JasonClock/CNC_Buck/docs/# buck 注意事项.md

# buck 注意事项
需要选择低DCR的电感，以减小影响满载效率的导通损耗（P=I^2^ * R)
可以高于目标值的饱和电流
