JasonClock/CNC_Buck/docs/项目出现的问题.md

# 项目设计时出现的问题
## 烧录问题
我的buck的板子的stm32f334r8在用daplink烧录时出现了下面的问题E:\clion\embedded_Env\openocd-v0.12.0-i686-w64-mingw32\bin\openocd.exe -s E:\clion\embedded_Env\openocd-v0.12.0-i686-w64-mingw32\share\openocd\scripts -f D:\stm32_workspace\all_kind_config_board\cmsisdap_stm32f3x.cfg -c "tcl_port disabled" -c "gdb_port disabled" -c "tcl_port disabled" -c "program \"D:/rm/DX_CNC buck/program/DX_CMC_Buck/build/Debug/DX_CMC_Buck.elf\"" -c reset -c shutdown
[0m[0mOpen On-Chip Debugger 0.12.0 (2023-01-14-23:37)
Licensed under GNU GPL v2
For bug reports, read
        http://openocd.org/doc/doxygen/bugs.html
Info : auto-selecting first available session transport "swd". To override use '
transport select <transport>'.
Info : Using CMSIS-DAPv2 interface with VID:PID=0xfaed:0x4870, serial=4866556863
11
Info : CMSIS-DAP: SWD supported
Info : CMSIS-DAP: JTAG supported
Info : CMSIS-DAP: Atomic commands supported
Info : CMSIS-DAP: UART via USB COM port supported
Info : CMSIS-DAP: FW Version = Horco v0.2
Info : CMSIS-DAP: Interface Initialised (SWD)
Info : SWCLK/TCK = 1 SWDIO/TMS = 1 TDI = 0 TDO = 1 nTRST = 0 nRESET = 1
Info : CMSIS-DAP: Interface ready
Info : clock speed 1000 kHz
Info : SWD DPIDR 0x2ba01477
Info : [stm32f3x.cpu] Cortex-M4 r0p1 processor detected
Info : [stm32f3x.cpu] target has 6 breakpoints, 4 watchpoints
Info : gdb port disabled
[stm32f3x.cpu] halted due to debug-request, current mode: Thread
xPSR: 0x01000000 pc: 0xfffffffe msp: 0xfffffffc
** Programming Started **
Info : device id = 0x10016438
Info : flash size = 64 KiB
Warn : Adding extra erase range, 0x08006ca4 .. 0x08006fff
Info : SWD DPIDR 0x2ba01477
Error: Failed to write memory at 0x20003004
Error: error writing to flash at address 0x08000000 at offset 0x00000000
embedded:startup.tcl:1516: Error: ** Programming Failed **
in procedure 'program'
in procedure 'program_error' called at file "embedded:startup.tcl", line 1581
at file "embedded:startup.tcl", line 1516

GPT解答：
你这个问题**大概率是 OpenOCD 的 STM32F3 默认 SRAM 工作区太大**，不是你的 flash 坏了。

关键日志是：

```text
Error: Failed to write memory at 0x20003004
Error: error writing to flash at address 0x08000000
```

`0x20003004` 很关键。

STM32F334R8 的普通 SRAM 是 **12 KB**，范围大约是：

```text
0x20000000 ~ 0x20002FFF
```

而 OpenOCD 正在尝试写：

```text
0x20003004
```

这已经超过了 12 KB SRAM 边界。STM32F334 还有 4 KB CCM RAM，但它不是接在 `0x20003000` 后面的连续 SRAM，OpenOCD 默认 flash loader 不能把它当作普通 work area 用。ST 官方资料也写了 F334x4/x6/x8 是最高 64 KB Flash、12 KB SRAM，另有 4 KB CCM SRAM。([STMicroelectronics](https://www.st.com/resource/en/datasheet/stm32f334k4.pdf?utm_source=chatgpt.com))

所以你的现象可以理解为：

```text
OpenOCD 连接芯片成功
↓
识别到 STM32F3 Cortex-M4 成功
↓
准备烧录 flash
↓
需要先把 flash programming algorithm 放到 SRAM 里运行
↓
但 OpenOCD 用了过大的 SRAM work area
↓
写到了 0x20003004，越界
↓
烧录失败
```

------

## 你应该这样改

找到你的这个配置文件：

```text
D:\stm32_workspace\all_kind_config_board\cmsisdap_stm32f3x.cfg
```

里面大概率有类似：

```tcl
source [find interface/cmsis-dap.cfg]
source [find target/stm32f3x.cfg]
```

你要在 `source [find target/stm32f3x.cfg]` **之前**加一行：

```tcl
set WORKAREASIZE 0x2000
```

推荐改成这样：

```tcl
source [find interface/cmsis-dap.cfg]

transport select swd
adapter speed 500

set WORKAREASIZE 0x2000

source [find target/stm32f3x.cfg]

reset_config none
```

`0x2000 = 8 KB`，比 12 KB 保守，基本不会越界。

也可以用：

```tcl
set WORKAREASIZE 0x2800
```

但我建议你先用 `0x2000`，稳定优先。

------

## 为什么不是直接设成 0x3000？

理论上 12 KB 就是：

```text
0x3000
```

但 flash loader 自己可能还会用到一点栈、临时变量或者对齐空间。为了避免刚好顶到边界，先用：

```text
0x2000
```

更稳。

------

## 你的日志里其他信息怎么看？

这些是正常的，说明连接没问题：

```text
Info : CMSIS-DAP: Interface Initialised (SWD)
Info : SWD DPIDR 0x2ba01477
Info : [stm32f3x.cpu] Cortex-M4 r0p1 processor detected
Info : flash size = 64 KiB
```

这句也符合 F334R8：

```text
Info : flash size = 64 KiB
```

异常的是这两句：

```text
pc: 0xfffffffe
msp: 0xfffffffc
```

这说明当前芯片里原本的程序向量表可能是无效的，或者 flash 内容还没烧进去/被擦坏了。这个本身不一定是根因，真正导致烧录失败的是后面的 SRAM 越界。

------

## 你也可以直接换命令测试

如果不用你自己的 `cmsisdap_stm32f3x.cfg`，可以临时这样试：

```bat
E:\clion\embedded_Env\openocd-v0.12.0-i686-w64-mingw32\bin\openocd.exe ^
-s E:\clion\embedded_Env\openocd-v0.12.0-i686-w64-mingw32\share\openocd\scripts ^
-f interface/cmsis-dap.cfg ^
-c "transport select swd" ^
-c "adapter speed 500" ^
-c "set WORKAREASIZE 0x2000" ^
-f target/stm32f3x.cfg ^
-c "program \"D:/rm/DX_CNC buck/program/DX_CMC_Buck/build/Debug/DX_CMC_Buck.elf\" verify reset exit"
```

注意：
`set WORKAREASIZE 0x2000` 必须在：

```text
-f target/stm32f3x.cfg
```

之前。

------

## 如果改完还是失败，再检查这几项

1. **SWD 速度先降到 100~500 kHz**

你的日志现在是：

```text
clock speed 1000 kHz
```

Buck 板子上电源噪声比较大，SWD 线又容易被功率部分干扰。可以先改：

```tcl
adapter speed 100
```

或者：

```tcl
adapter speed 500
```

1. **烧录时先不要给 Buck 主功率 48 V 上电**

只给 STM32 的 3.3 V，最好先断开 MOS 驱动、电感功率部分。
你这个是数控 Buck 板，功率地、电流采样、HRTIM PWM、驱动芯片都可能在上电瞬间制造干扰。

1. **BOOT0 下拉确认**

BOOT0 建议 10 kΩ 下拉到 GND。
如果 BOOT0 悬空，启动模式可能异常。

1. **NRST 接线检查**

DAPLink 的 `nRESET` 最好接到 STM32 的 NRST。
如果你的程序一启动就把 SWD 引脚配置错、进低功耗、开看门狗，后续可能需要 connect under reset。

1. **确认没有把 PA13/PA14 当普通 IO 用**

STM32F334 的 SWD 一般是：

```text
PA13 = SWDIO
PA14 = SWCLK
NRST = Reset
GND = GND
3V3 = VTref
```

------

## 结论

你这个日志最像：

```text
OpenOCD stm32f3x.cfg 默认 WORKAREASIZE = 0x4000
但 STM32F334R8 普通 SRAM 只有 0x3000
所以烧录算法写 SRAM 越界，导致 flash programming failed
```

优先修复：

```tcl
set WORKAREASIZE 0x2000
```

并且一定放在：

```tcl
source [find target/stm32f3x.cfg]
```

之前。
