JasonClock/CNC_Buck/(list of files, drawings)

Other design files:
docs/开关电路.ms14
docs/缓启动.ms14
