JasonClock/CNC_Buck/circuit/数控电源/数控buck.kicad_pcb

## KiCad design circuit/数控电源/数控buck.kicad_pcb (2026-05-04)

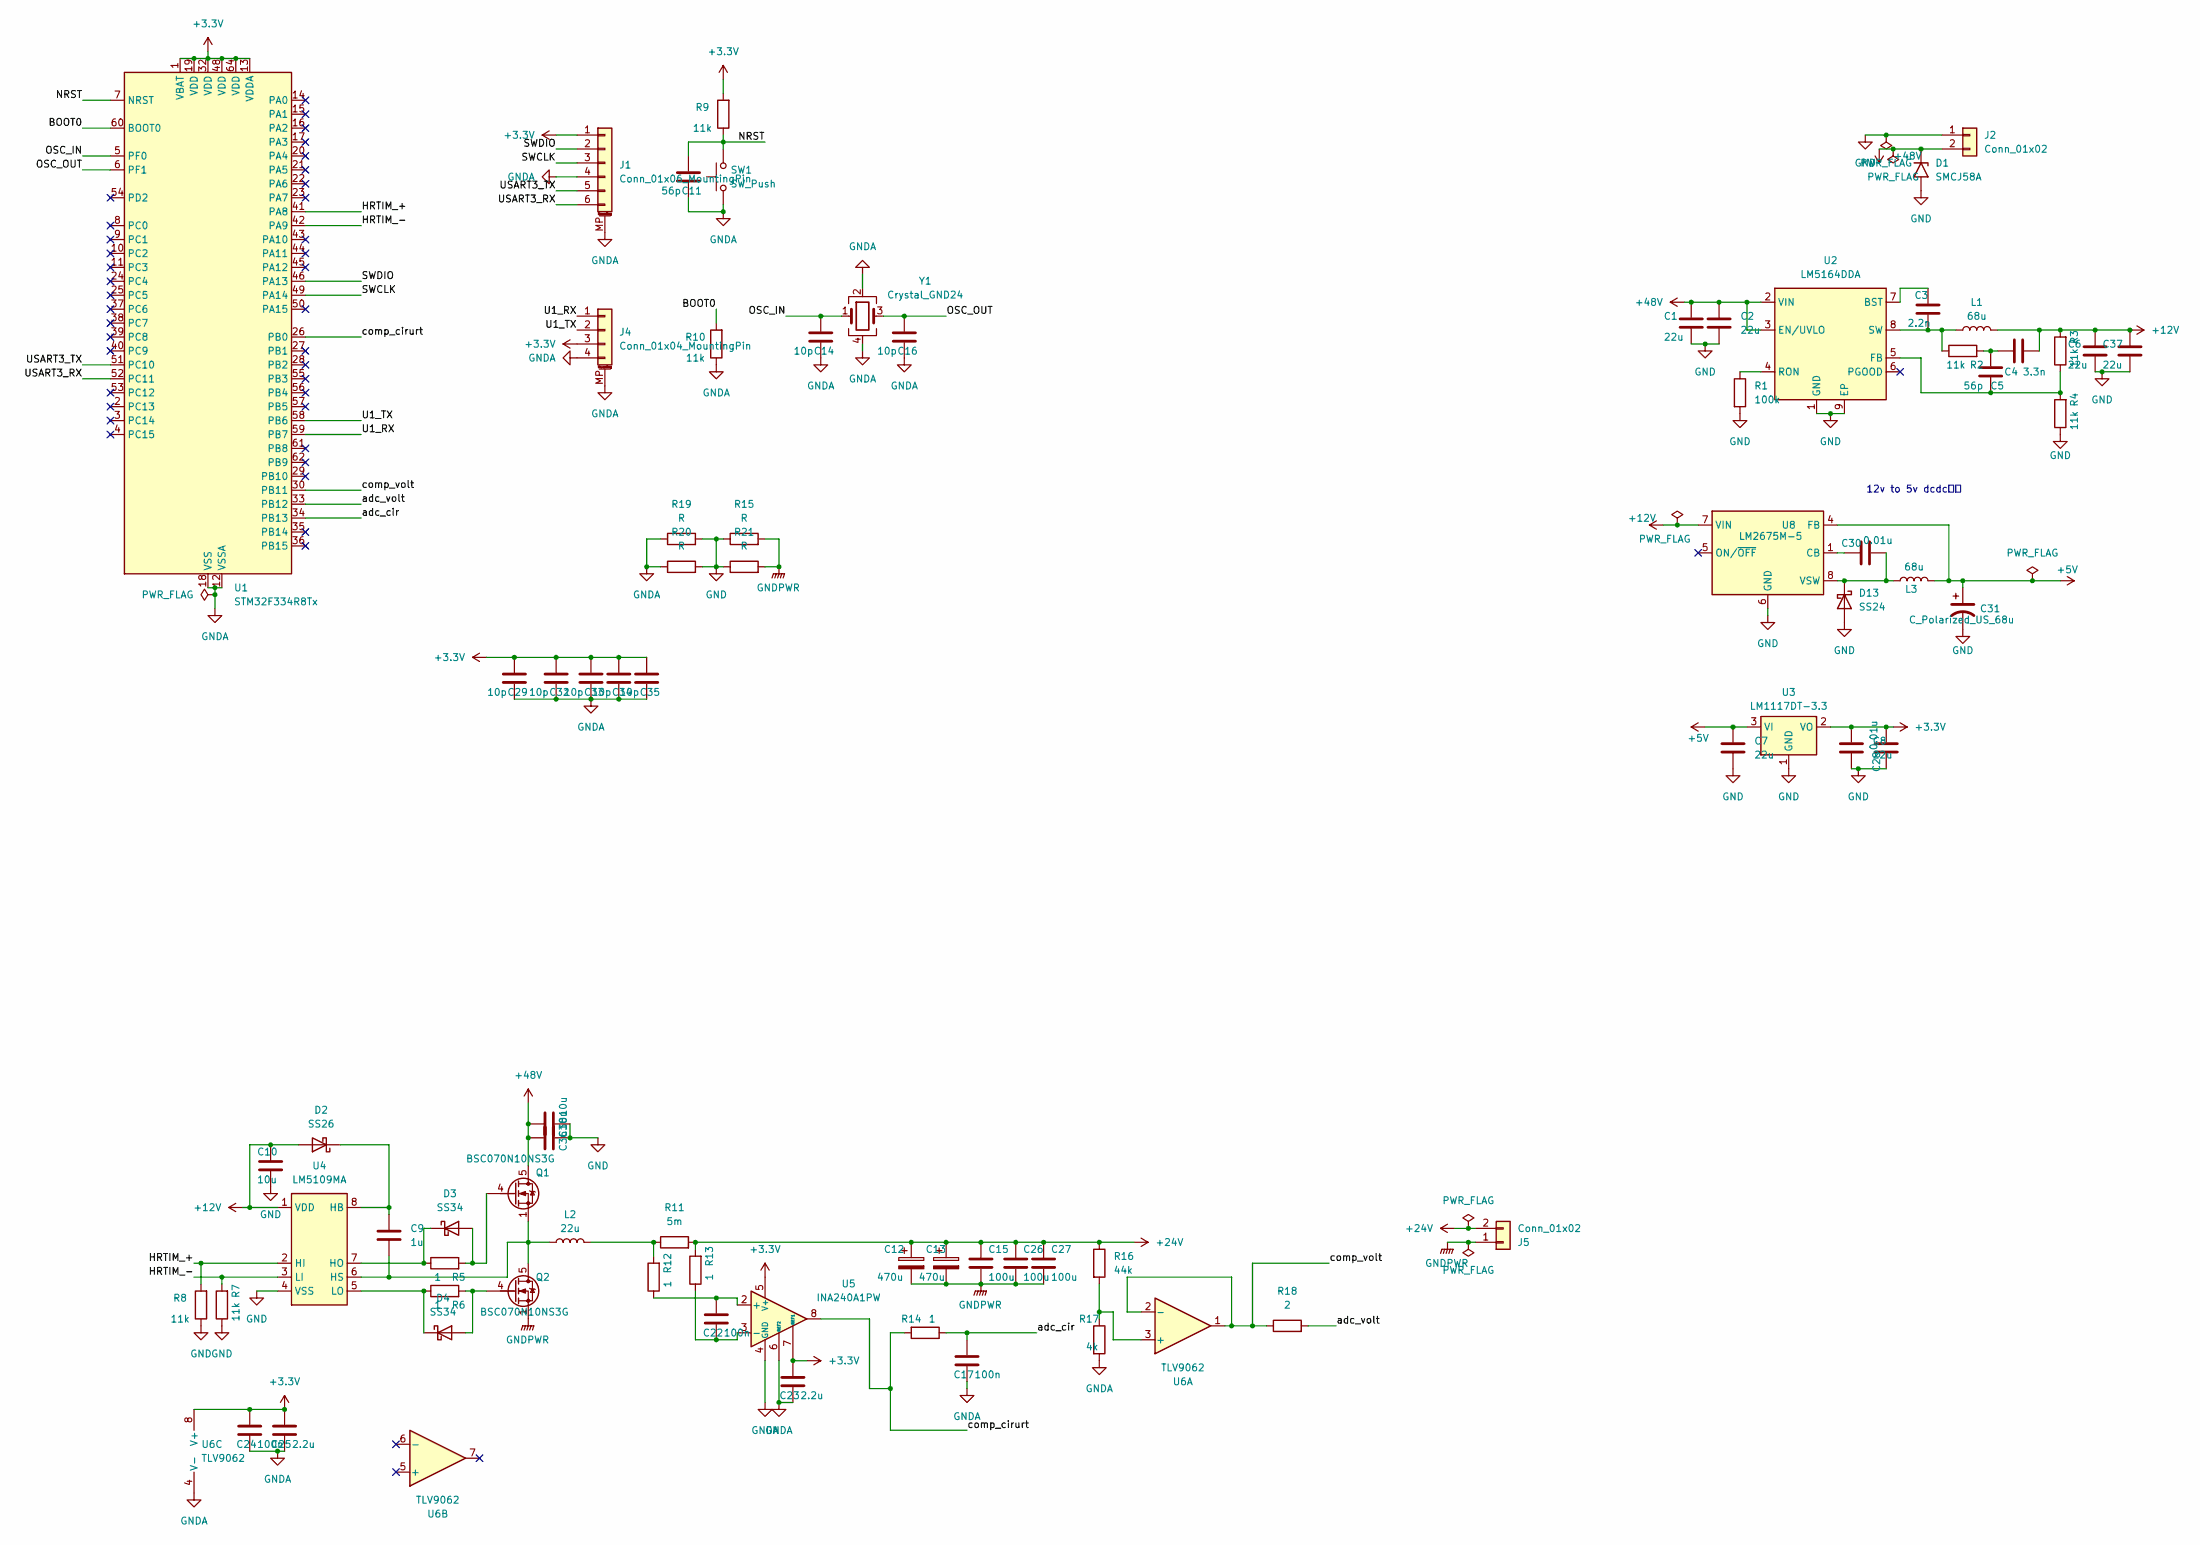
[picture p1: schematic 数控buck.kicad_sch]

Parts:
C1, C2, C6, C7, C8, C37: 22u; C_0805_2012Metric_Pad1.18x1.45mm_HandSolder
C3: 2.2n; C_0603_1608Metric
C4: 3.3n; C_0603_1608Metric
C5, C11: 56p; C_0603_1608Metric
C9: 1u; C_0805_2012Metric_Pad1.18x1.45mm_HandSolder
C10: 10u; C_0805_2012Metric_Pad1.18x1.45mm_HandSolder
C12, C13: 470u; CP_Elec_10x10.5
C14, C16, C29, C32, C33, C34, C35: 10p; C_0603_1608Metric
C15, C26, C27: 100u; C_0805_2012Metric_Pad1.18x1.45mm_HandSolder
C17, C22, C24: 100n; C_0603_1608Metric
C23, C25: 2.2u; C_0603_1608Metric
C28, C30: 0.01u; C_0603_1608Metric_Pad1.08x0.95mm_HandSolder
C31: C_Polarized_US_68u; CP_EIA-7343-31_Kemet-D
C36, C38: 10u; C_1206_3216Metric
D1: SMCJ58A; D_SMB
D2: SS26; D_SMA
D3, D4: SS34; D_SMA
D13: SS24; D_SMA
J1: Conn_01x06_MountingPin; JST_GH_SM06B-GHS-TB_1x06-1MP_P1.25mm_Horizontal
J2: Conn_01x02; AMASS_XT30U-M_1x02_P5.0mm_Vertical
J4: Conn_01x04_MountingPin; JST_GH_SM04B-GHS-TB_1x04-1MP_P1.25mm_Horizontal
J5: Conn_01x02; AMASS_XT30U-F_1x02_P5.0mm_Vertical
L1: 68u; L_Bourns_SRP7028A_7.3x6.6mm
L2: 22u; L_APV_APH1770
L3: 68u; L_7.3x7.3_H3.5
Q1, Q2: BSC070N10NS3G; TDSON-8-1
R1: 100k; R_0603_1608Metric_Pad0.98x0.95mm_HandSolder
R2, R3, R4, R7, R8, R10: 11k; R_0603_1608Metric_Pad0.98x0.95mm_HandSolder
R5, R6, R12, R13, R14: 1; R_0603_1608Metric_Pad0.98x0.95mm_HandSolder
R9: 11k; R_0603_1608Metric
R11: 5m; R_2512_6332Metric_Pad1.40x3.35mm_HandSolder
R15, R19, R20, R21: R; R_0805_2012Metric_Pad1.20x1.40mm_HandSolder
R16: 44k; R_0603_1608Metric_Pad0.98x0.95mm_HandSolder
R17: 4k; R_0603_1608Metric_Pad0.98x0.95mm_HandSolder
R18: 2; R_0603_1608Metric_Pad0.98x0.95mm_HandSolder
SW1: SW_Push; SW_Push_SPST_NO_Alps_SKRK
U1: STM32F334R8Tx; LQFP-64_10x10mm_P0.5mm
U2: LM5164DDA; HSOP-8-1EP_3.9x4.9mm_P1.27mm_EP2.41x3.1mm_ThermalVias
U3: LM1117DT-3.3; TO-252-3_TabPin2
U4: LM5109MA; SOIC-8_3.9x4.9mm_P1.27mm
U5: INA240A1PW; TSSOP-8_4.4x3mm_P0.65mm
U6: TLV9062; SOIC-8_3.9x4.9mm_P1.27mm
U8: LM2675M-5; SOIC-8_3.9x4.9mm_P1.27mm
Y1: Crystal_GND24; Crystal_SMD_3225-4Pin_3.2x2.5mm_HandSoldering

Connections:
+3.3V: C8.1, C23.2, C24.2, C25.2, C28.2, C29.2, C32.2, C33.2, C34.2, C35.2, J1.1, J4.3, R9.2, U1.1 (VBAT), U1.13 (VDDA), U1.19 (VDD), U1.32 (VDD), U1.48 (VDD), U1.64 (VDD), U3.2 (VO), U5.5 (V+), U5.7 (REF1), U6.8 (V+)
+5V: C7.1, C31.1, L3.2, U3.3 (VI), U8.4 (FB)
+12V: C4.2, C6.1, C10.1, C37.1, D2.2 (A), L1.2, R3.2, U4.1 (VDD), U8.7 (VIN)
+24V: C12.1, C13.1, C15.1, C26.1, C27.1, J5.2, R11.2, R13.2, R16.1
+48V: C1.1, C2.1, C36.2, C38.2, D1.1 (A1), J2.2, Q1.5 (D), U2.2 (VIN), U2.3 (EN/UVLO)
/BOOT0: R10.2, U1.60 (BOOT0)
/HRTIM_+: R8.2, U1.41 (PA8), U4.2 (HI)
/HRTIM_-: R7.2, U1.42 (PA9), U4.3 (LI)
/NRST: C11.2, R9.1, SW1.2, U1.7 (NRST)
/OSC_IN: C14.2, U1.5 (PF0), Y1.1
/OSC_OUT: C16.2, U1.6 (PF1), Y1.3
/SWCLK: J1.3, U1.49 (PA14)
/SWDIO: J1.2, U1.46 (PA13)
/U1_RX: J4.1, U1.59 (PB7)
/U1_TX: J4.2, U1.58 (PB6)
/USART3_RX: J1.6, U1.52 (PC11)
/USART3_TX: J1.5, U1.51 (PC10)
/adc_cir: C17.2, R14.1, U1.34 (PB13)
/adc_volt: R18.2, U1.33 (PB12)
/comp_cirurt: R14.2, U1.26 (PB0), U5.8
/comp_volt: R18.1, U1.30 (PB11), U6.1, U6.2 (-)
GND: C1.2, C2.2, C6.2, C7.2, C8.2, C10.2, C28.1, C31.2, C36.1, C37.2, C38.1, D1.2 (A2), D13.2 (A), J2.1, R1.2, R4.1, R7.1, R8.1, R15.1, R19.2, R20.2, R21.1, U2.1 (GND), U2.9 (EP), U3.1 (GND), U4.4 (VSS), U8.6 (GND)
GNDA: C11.1, C14.1, C16.1, C17.1, C23.1, C24.1, C25.1, C29.1, C32.1, C33.1, C34.1, C35.1, J1.4, J1.MP (MountPin), J4.4, J4.MP (MountPin), R10.1, R17.2, R19.1, R20.1, SW1.1, U1.12 (VSSA), U1.18 (VSS), U1.31 (VSS), U1.47 (VSS), U1.63 (VSS), U5.1 (GND), U5.4 (GND), U5.6 (REF2), U6.4 (V-), Y1.2, Y1.4
GNDPWR: C12.2, C13.2, C15.2, C26.2, C27.2, J5.1, Q2.1 (S), Q2.2 (S), Q2.3 (S), R15.2, R21.2
unnamed: C4.1, C5.2, R2.2
unnamed: C9.1, D2.1 (K), U4.8 (HB)
unnamed: D3.2 (A), Q1.4 (G), R5.2
unnamed: D3.1 (K), R5.1, U4.7 (HO)
unnamed: D4.2 (A), Q2.4 (G), R6.2
unnamed: D4.1 (K), R6.1, U4.5 (LO)
unnamed: C30.2, D13.1 (K), L3.1, U8.8 (VSW)
unnamed: L2.2, R11.1, R12.2
unnamed: C9.2, L2.1, Q1.1 (S), Q1.2 (S), Q1.3 (S), Q2.5 (D), U4.6 (HS)
unnamed: C3.1, U2.7 (BST)
unnamed: C5.1, R3.1, R4.2, U2.5 (FB)
unnamed: R1.1, U2.4 (RON)
unnamed: C3.2, L1.1, R2.1, U2.8 (SW)
unnamed: C22.2, R12.1, U5.2 (+)
unnamed: C22.1, R13.1, U5.3 (-)
unnamed: R16.2, R17.1, U6.3 (+)
unnamed: C30.1, U8.1 (CB)

Notes on the sheet:
12v to 5v dcdc电路

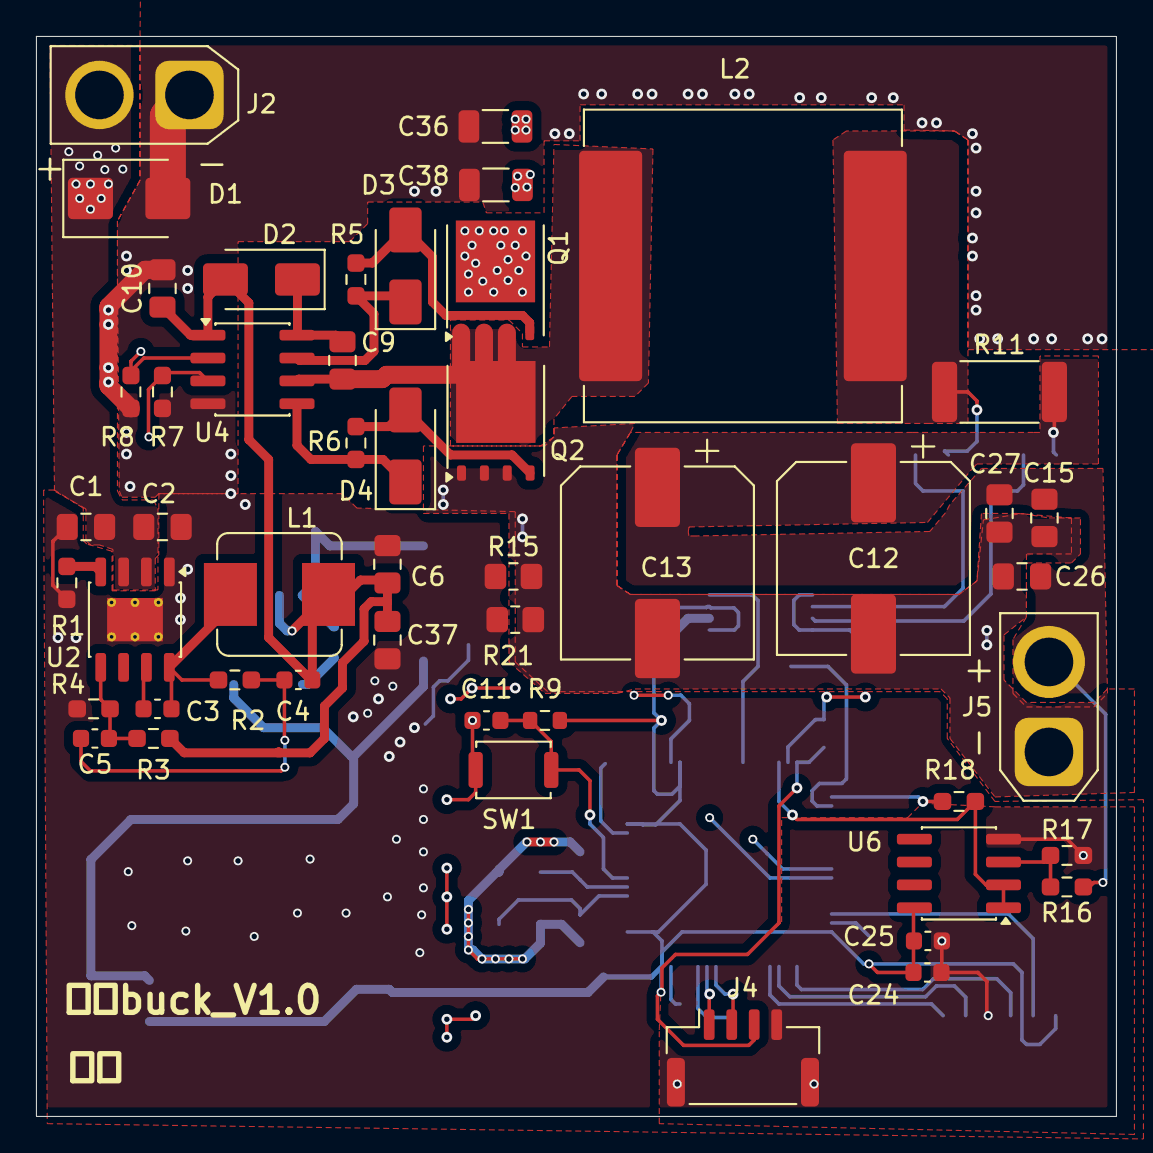
[picture p2: board 数控buck.kicad_pcb from above]

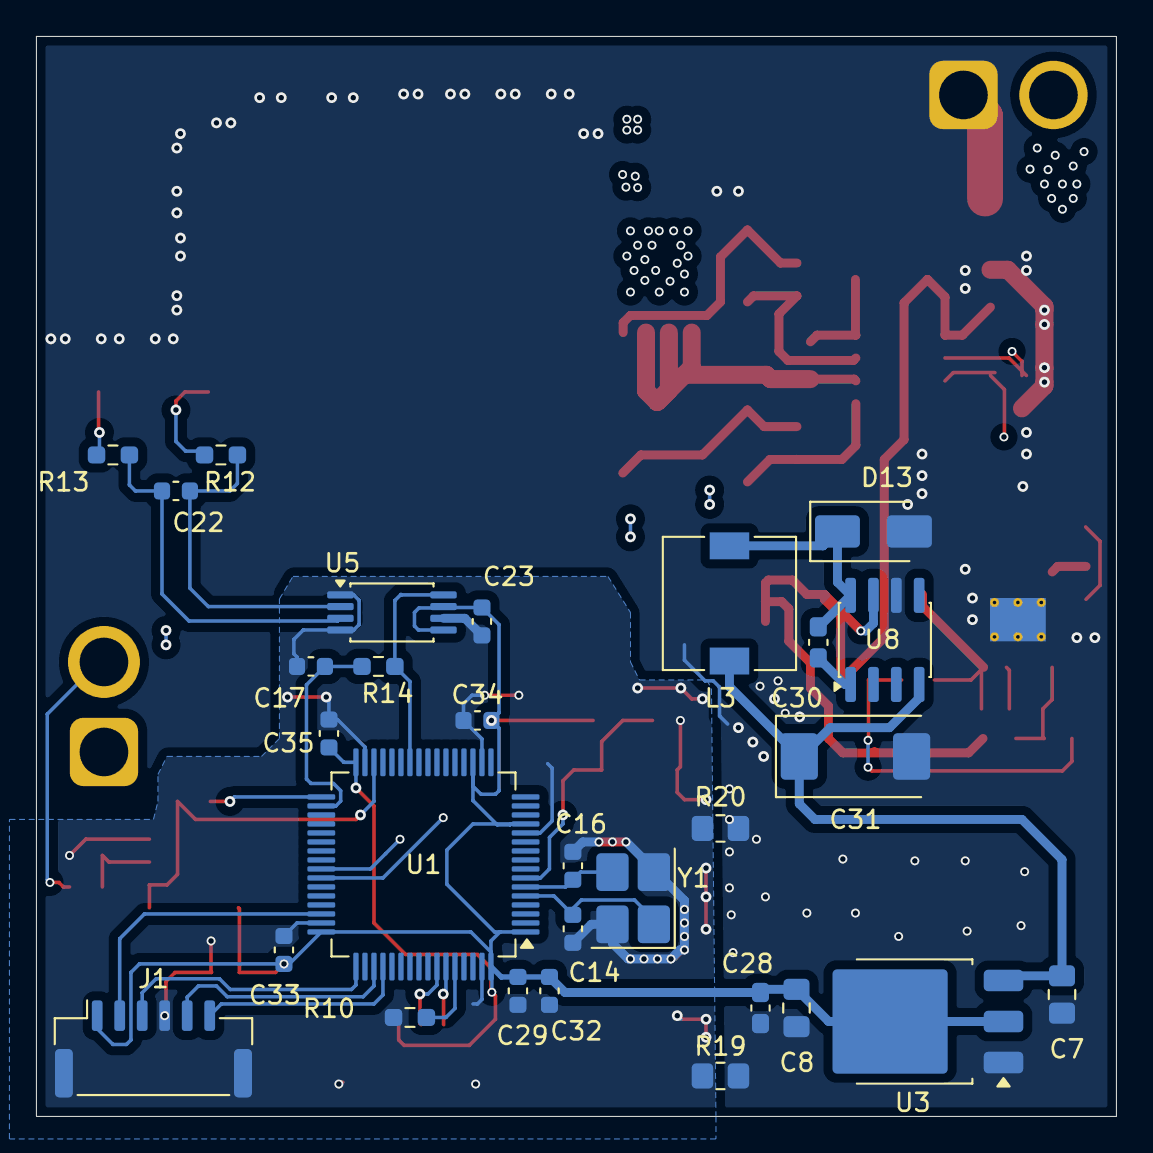
[picture p3: board 数控buck.kicad_pcb from below]

Board: 4 copper layers, 60.0 x 60.0 mm, 78 parts (29 on the bottom side), 41 nets.
