JasonClock/CNC_Buck/program/DX_CMC_Buck/DX_CMC_Buck.ioc

Mcu.UserName=STM32F334R8Tx
PA13.Signal=SYS_JTMS-SWDIO
PA14.Signal=SYS_JTCK-SWCLK
PA5.Signal=COMP_DAC12_group
PA6.Signal=COMP_DAC21_group
PA8.Signal=HRTIM1_CHA1
PA9.Signal=HRTIM1_CHA2
PB0.Signal=COMP4_INP
PB11.Signal=COMP6_INP
PB12.Signal=ADC2_IN13
PB13.Signal=ADC1_IN13
PC10.Signal=USART3_TX
PC11.Signal=USART3_RX
PC4.Signal=USART1_TX
PC5.Signal=USART1_RX
