JasonClock/CNC_Buck/program/DX_CMC_Buck/Core/Src/comp.c

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
/* Includes ------------------------------------------------------------------*/
#include "comp.h"

COMP_HandleTypeDef hcomp4;
COMP_HandleTypeDef hcomp6;

/* COMP4 init function */
void MX_COMP4_Init(void)
{

  hcomp4.Instance = COMP4;
  hcomp4.Init.InvertingInput = COMP_INVERTINGINPUT_DAC1_CH2;
  hcomp4.Init.NonInvertingInput = COMP_NONINVERTINGINPUT_IO1;
  hcomp4.Init.Output = COMP_OUTPUT_NONE;
  hcomp4.Init.OutputPol = COMP_OUTPUTPOL_NONINVERTED;
  hcomp4.Init.BlankingSrce = COMP_BLANKINGSRCE_NONE;
  hcomp4.Init.TriggerMode = COMP_TRIGGERMODE_IT_RISING;
  if (HAL_COMP_Init(&hcomp4) != HAL_OK)
  {
    Error_Handler();
  }
}
/* COMP6 init function */
void MX_COMP6_Init(void)
{

  hcomp6.Instance = COMP6;
  hcomp6.Init.InvertingInput = COMP_INVERTINGINPUT_DAC2_CH1;
  hcomp6.Init.NonInvertingInput = COMP_NONINVERTINGINPUT_IO1;
  hcomp6.Init.Output = COMP_OUTPUT_NONE;
  hcomp6.Init.OutputPol = COMP_OUTPUTPOL_NONINVERTED;
  hcomp6.Init.BlankingSrce = COMP_BLANKINGSRCE_NONE;
  hcomp6.Init.TriggerMode = COMP_TRIGGERMODE_IT_RISING;
  if (HAL_COMP_Init(&hcomp6) != HAL_OK)
  {
    Error_Handler();
  }
}

void HAL_COMP_MspInit(COMP_HandleTypeDef* compHandle)
{

  GPIO_InitTypeDef GPIO_InitStruct = {0};
  if(compHandle->Instance==COMP4)
  {
    __HAL_RCC_GPIOB_CLK_ENABLE();
    /**COMP4 GPIO Configuration
    PB0     ------> COMP4_INP
    */
    GPIO_InitStruct.Pin = GPIO_PIN_0;
    GPIO_InitStruct.Mode = GPIO_MODE_ANALOG;
    GPIO_InitStruct.Pull = GPIO_NOPULL;
    HAL_GPIO_Init(GPIOB, &GPIO_InitStruct);

    /* COMP4 interrupt Init */
    HAL_NVIC_SetPriority(COMP4_6_IRQn, 0, 0);
    HAL_NVIC_EnableIRQ(COMP4_6_IRQn);
  }
  else if(compHandle->Instance==COMP6)
  {
    __HAL_RCC_GPIOB_CLK_ENABLE();
    /**COMP6 GPIO Configuration
    PB11     ------> COMP6_INP
    */
    GPIO_InitStruct.Pin = GPIO_PIN_11;
    GPIO_InitStruct.Mode = GPIO_MODE_ANALOG;
    GPIO_InitStruct.Pull = GPIO_NOPULL;
    HAL_GPIO_Init(GPIOB, &GPIO_InitStruct);

    /* COMP6 interrupt Init */
    HAL_NVIC_SetPriority(COMP4_6_IRQn, 0, 0);
    HAL_NVIC_EnableIRQ(COMP4_6_IRQn);
  }
}

void HAL_COMP_MspDeInit(COMP_HandleTypeDef* compHandle)
{

  if(compHandle->Instance==COMP4)
  {
    /**COMP4 GPIO Configuration
    PB0     ------> COMP4_INP
    */
    HAL_GPIO_DeInit(GPIOB, GPIO_PIN_0);

    /* COMP4 interrupt Deinit */
  /* USER CODE BEGIN COMP4:COMP4_6_IRQn disable */
    /**
    * Uncomment the line below to disable the "COMP4_6_IRQn" interrupt
    * Be aware, disabling shared interrupt may affect other IPs
    */
    /* HAL_NVIC_DisableIRQ(COMP4_6_IRQn); */
  /* USER CODE END COMP4:COMP4_6_IRQn disable */

  }
  else if(compHandle->Instance==COMP6)
  {
    /**COMP6 GPIO Configuration
    PB11     ------> COMP6_INP
    */
    HAL_GPIO_DeInit(GPIOB, GPIO_PIN_11);

    /* COMP6 interrupt Deinit */
  /* USER CODE BEGIN COMP6:COMP4_6_IRQn disable */
    /**
    * Uncomment the line below to disable the "COMP4_6_IRQn" interrupt
    * Be aware, disabling shared interrupt may affect other IPs
    */
    /* HAL_NVIC_DisableIRQ(COMP4_6_IRQn); */
  /* USER CODE END COMP6:COMP4_6_IRQn disable */

  }
}
