JasonClock/CNC_Buck/(commit log)

2026-04-28 commit sch
    [buc.kicad_sch, buck.kicad_sch, untitled.kicad_sch, 供电.kicad_sch, 开关电路.ms14, 数控buck.kicad_pcb, 数控buck.kicad_sch, 数控电源_自制.kicad_pcb]
2026-04-30 finish circuir_V1.0
    [数控buck.kicad_pcb]
2026-05-04 配置了dac和comp和hrtim定时器
    [buc.kicad_sch, buck.kicad_sch, untitled.kicad_sch, 供电.kicad_sch, 数控buck.kicad_pcb, 数控buck.kicad_sch]
2026-05-04 buck电路板第一版
    [数控buck-B_Cu.gbr, 数控buck-B_Mask.gbr, 数控buck-B_Paste.gbr, 数控buck-B_Silkscreen.gbr, 数控buck-Edge_Cuts.gbr, 数控buck-F_Cu.gbr, 数控buck-F_Mask.gbr, 数控buck-F_Paste.gbr]
2026-05-05 添加了分层
2026-05-05 重命名hrtim.c为DAC.c并添加DAC相关头文件和实现
2026-05-05 添加STM32F3系列微控制器的基础代码和配置文件
2026-05-05 重构DAC相关代码，重命名头文件并添加新实现，更新CMake配置
2026-05-12 添加UART协议相关代码，更新ADC和DAC配置，修改GPIO和HRTIM设置
2026-05-12 PCB图自动保存
