JasonClock/CNC_Buck/(notices)

Notices in the files:
program/DX_CMC_Buck/Core/Src/comp.c:
Copyright (c) 2026 STMicroelectronics.
All rights reserved.
This software is licensed under terms that can be found in the LICENSE file
